sokrasins/name-tag/docs/nametag_back_render_bottom.png

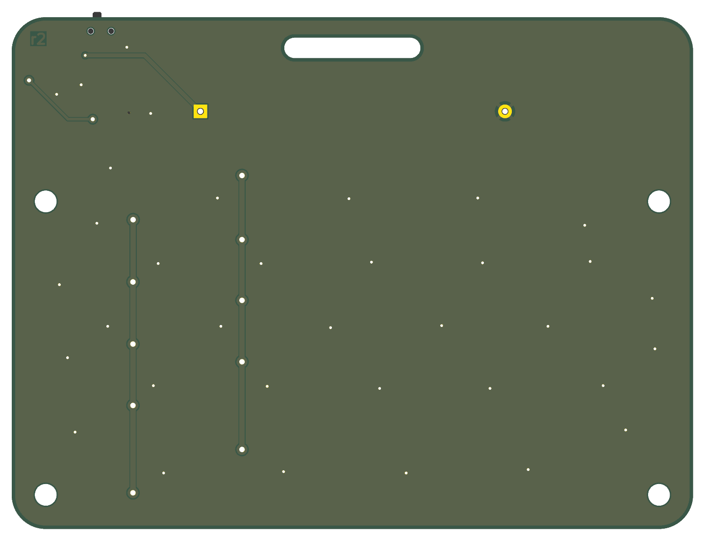
docs/nametag_back_render_bottom.png
