sokrasins/name-tag/docs/nametag_front_render_bottom.png

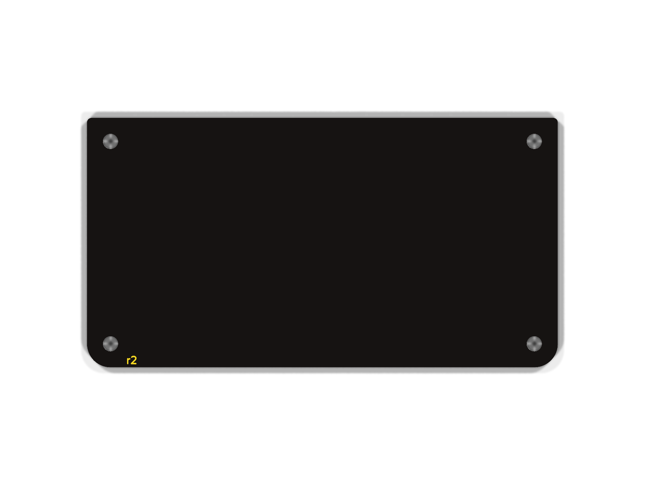
docs/nametag_front_render_bottom.png
