sokrasins/name-tag/bom/bom.csv

 | Sourced | References | Value | Footprint | Quantity | LCSC Part No. | Digikey Part No.
1 | x | C1 | 2.2 uF | C_0805_2012Metric | 1 | C19110
2 | x | C2 | 22 uF | C_0805_2012Metric | 1 | C602037
3 | x | R1, R2, R3, R4, R5, R6, R7, R8, R9, R10, R11, R12, R13, R14, R15, R16, R17, R18, R19, R20, R21, R22, R23, R24, R25, R26, R27 | 1k | R_0805_2012Metric | 27 | C95781
4 | x | L1 | 4.7 uH | L_0805_2012Metric | 1 | C395016
5 | x | D1, D2, D3, D4, D5, D6, D7, D8, D9, D10, D11, D12, D13, D14, D15, D16, D17, D18, D19, D20, D21, D22, D23, D24, D25, D26, D27 | LED | LED_1206_3216Metric | 27 | C3646935
6 | x | U1 | TPS613221ADBV | SOT-23-5 | 1 | C2071121
7 | x | SW2 | SW_SPDT | SW_SPDT_PCM12 | 1 | C221841
8 | x | Q1, Q2, Q3, Q4, Q5, Q6, Q7, Q8, Q9, Q10, Q11, Q12, Q13, Q14, Q15, Q16, Q17, Q18, Q19, Q20, Q21, Q22, Q23, Q24, Q25, Q26, Q27 | BSS138 | SOT-23 | 27 | C2874697
9 | x | BT1 | AAA (1.5V) | BatteryHolder_Keystone_2466_1xAAA | 1 |  | 36-2466-ND
10 | x | RV1 | 10k | Potentiometer_Bourns_TC33X_Vertical | 1 | C719176
11 | x | PCB – Front |  |  | 1
12 | x | PCB – Back |  |  | 1
13 | x | Stencil |  |  | 1
