sokrasins/name-tag/docs/nametag_back_schematic_rev2.pdf

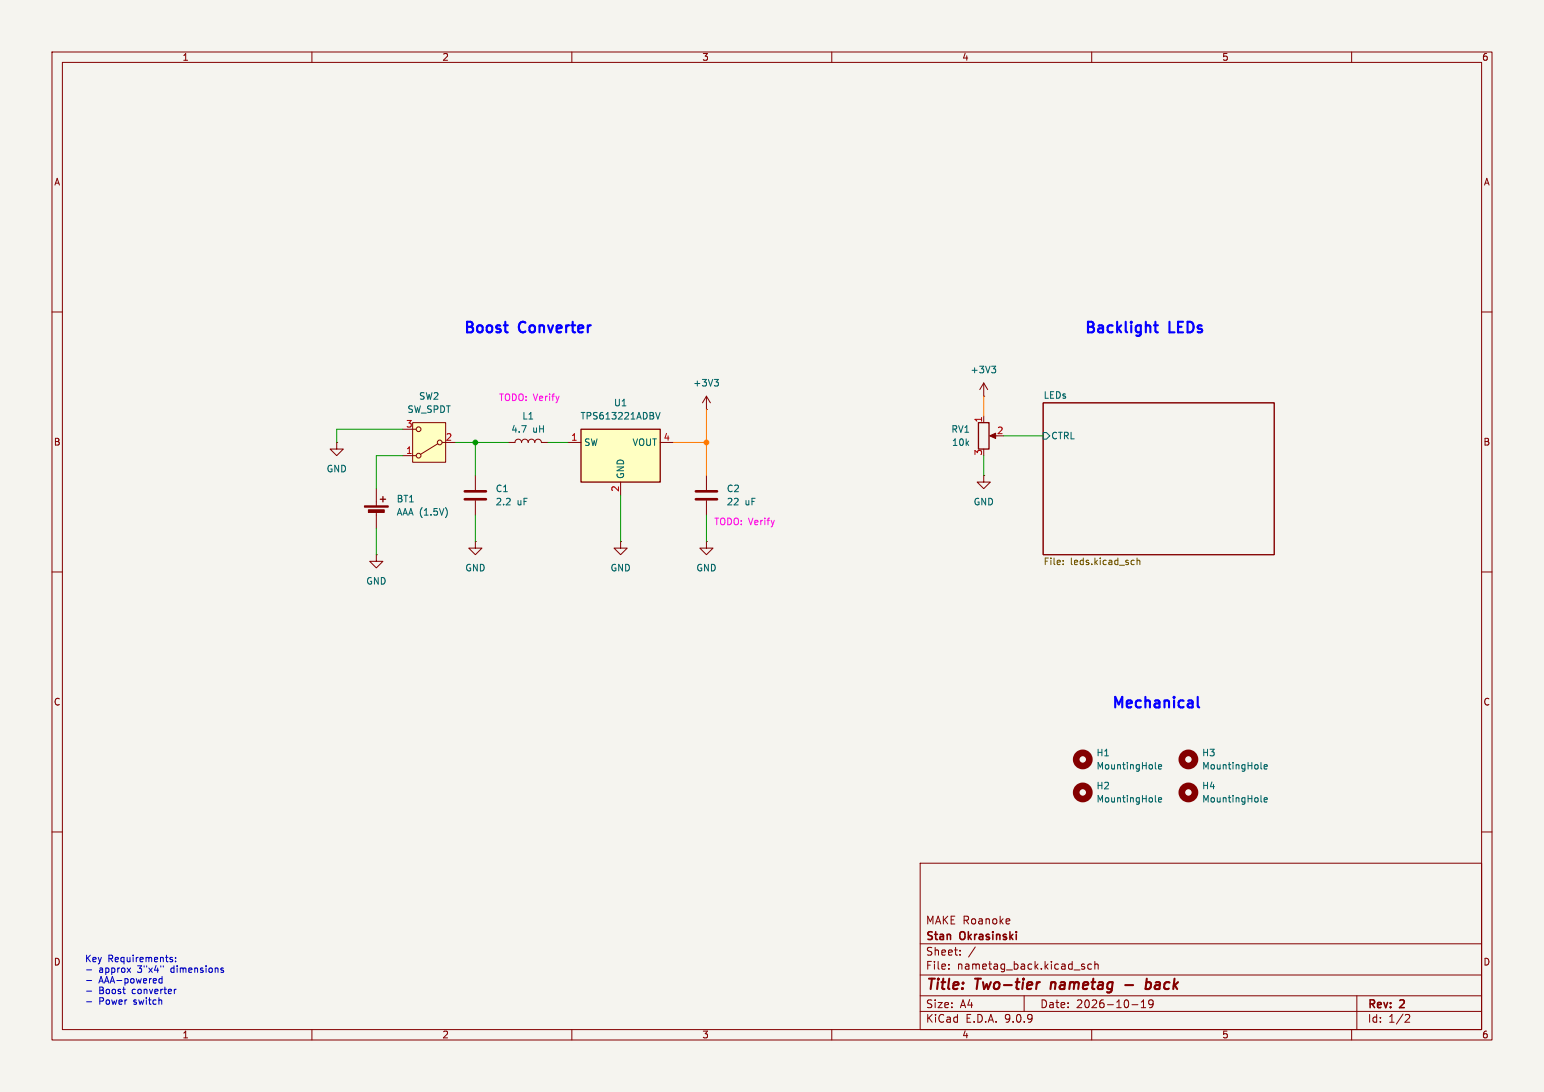
[picture p5: page 1]

H4 MountingHole H3 MountingHole H1 MountingHole H2 MountingHole GND

File: nametag_back.kicad_sch Sheet: / Stan Okrasinski MAKE Roanoke

Key Requirements: - approx 3"x4" dimensions
- AAA-powered
- Boost converter

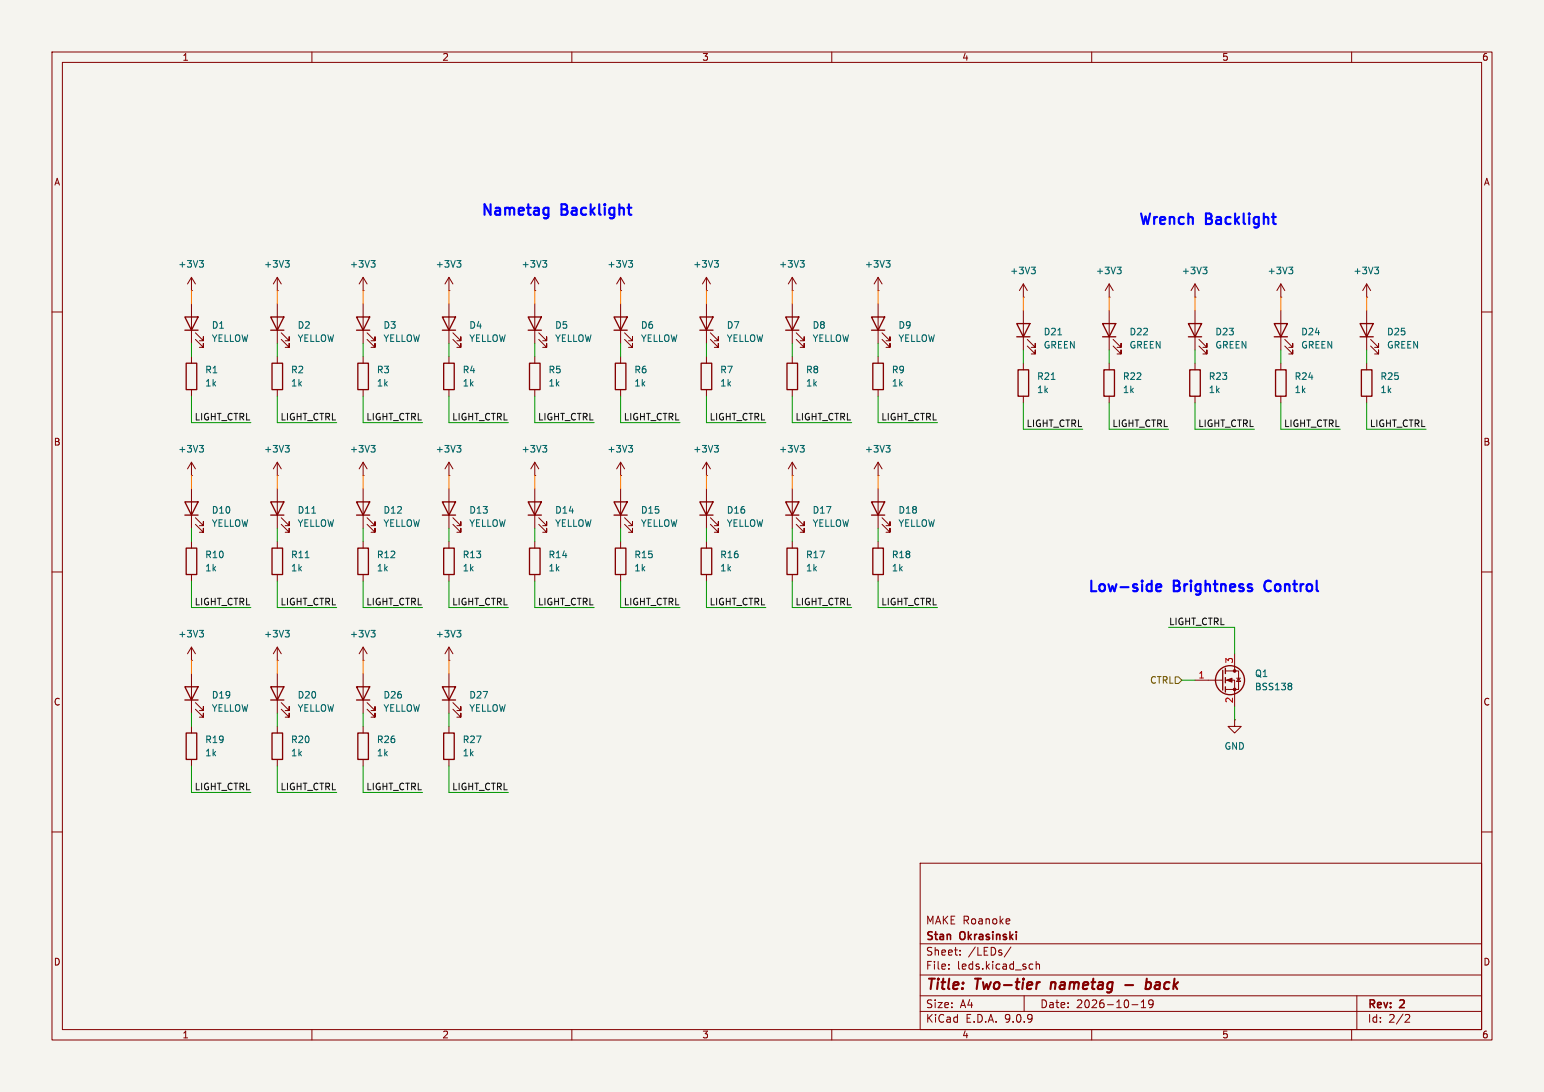
[picture p6: page 2]

File: leds.kicad_sch Sheet: /LEDs/ Stan Okrasinski MAKE Roanoke D14 YELLOW
