sokrasins/name-tag/nametag_back/oven_nametag.kicad_pcb

## KiCad design nametag_back/oven_nametag.kicad_pcb (2026-10-20)

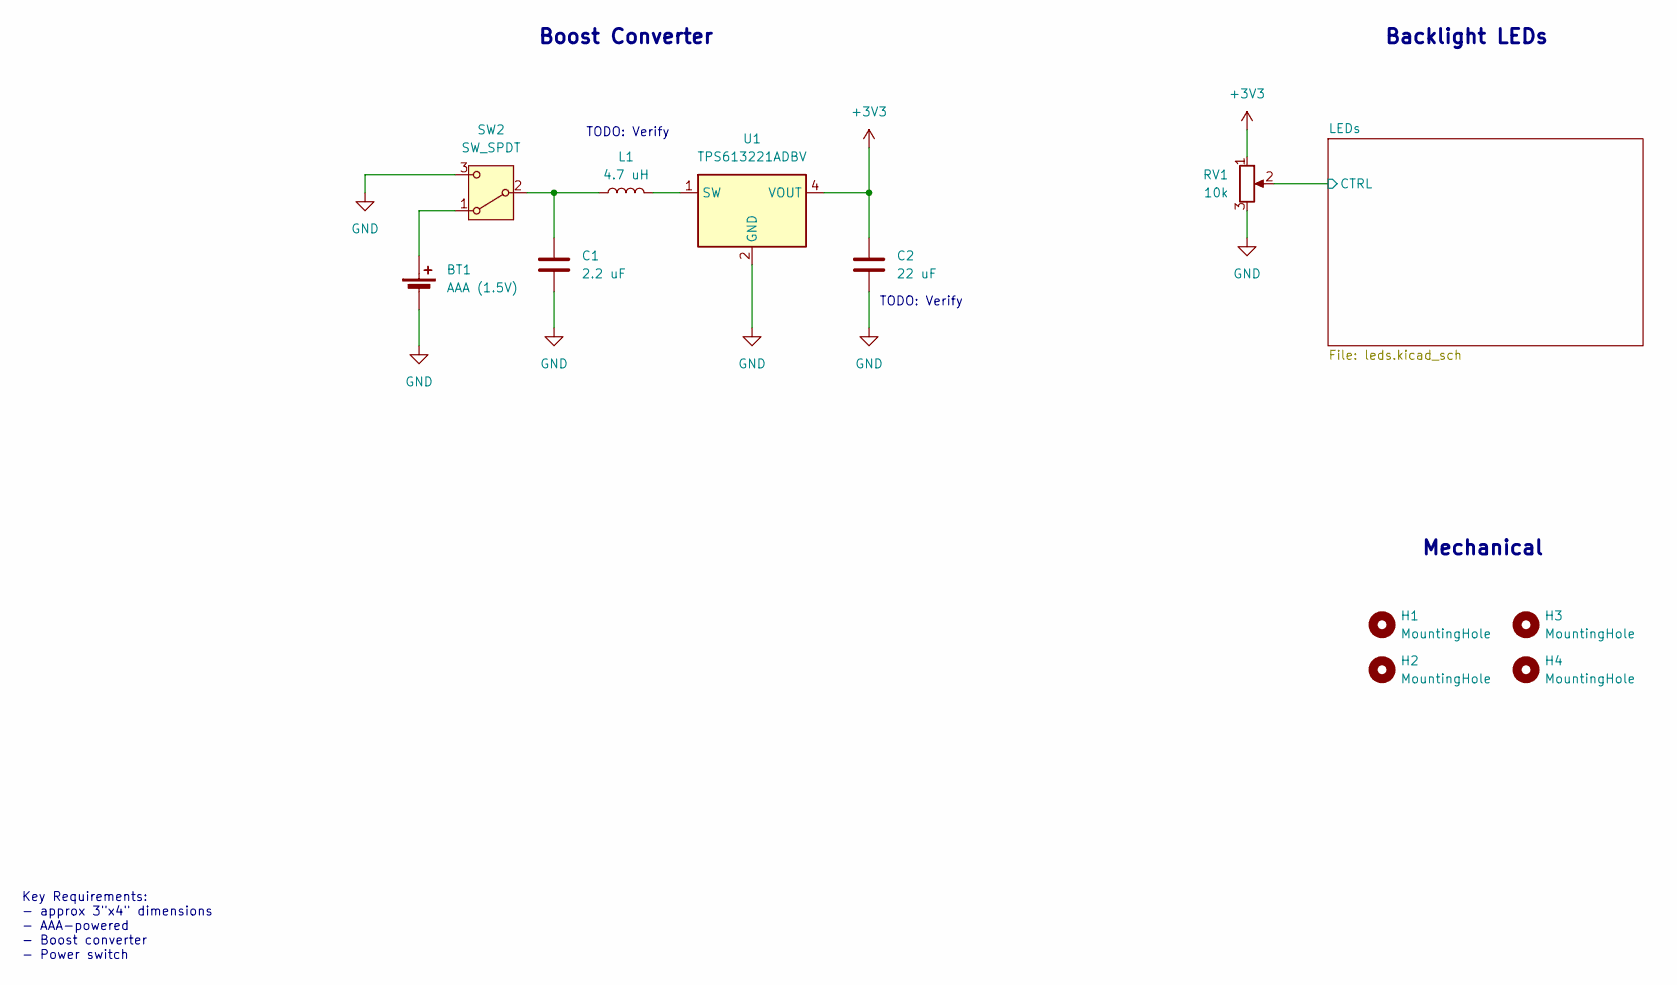
[picture p9: schematic oven_nametag.kicad_sch, Two-tier nametag - back]

Parts:
BT1: AAA (1.5V); BatteryHolder_Keystone_2466_1xAAA
C1: 2.2 uF; C_0805_2012Metric
C2: 22 uF; C_0805_2012Metric
H1, H2, H3, H4: MountingHole; MountingHole_3.2mm_M3
L1: 4.7 uH; L_0805_2012Metric
RV1: 10k; Potentiometer_Bourns_TC33X_Vertical
SW2: SW_SPDT; SW_SPDT_PCM12
U1: TPS613221ADBV; SOT-23-5

Connections:
+3V3: C2.1, RV1.1, U1.4 (VOUT); also elsewhere on the board
/LEDs/CTRL: RV1.2; also elsewhere on the board
GND: BT1.2 (-), C1.2, C2.2, RV1.3, SW2.3 (C), U1.2 (GND); also elsewhere on the board
unnamed: BT1.1 (+), SW2.1 (A)
unnamed: C1.1, L1.1, SW2.2 (B)
unnamed: L1.2, U1.1 (SW)

Notes on the sheet:
Backlight LEDs
TODO: Verify
Boost Converter
Key Requirements: - approx 3"x4" dimensions - AAA-powered - Boost converter - Power switch
Mechanical

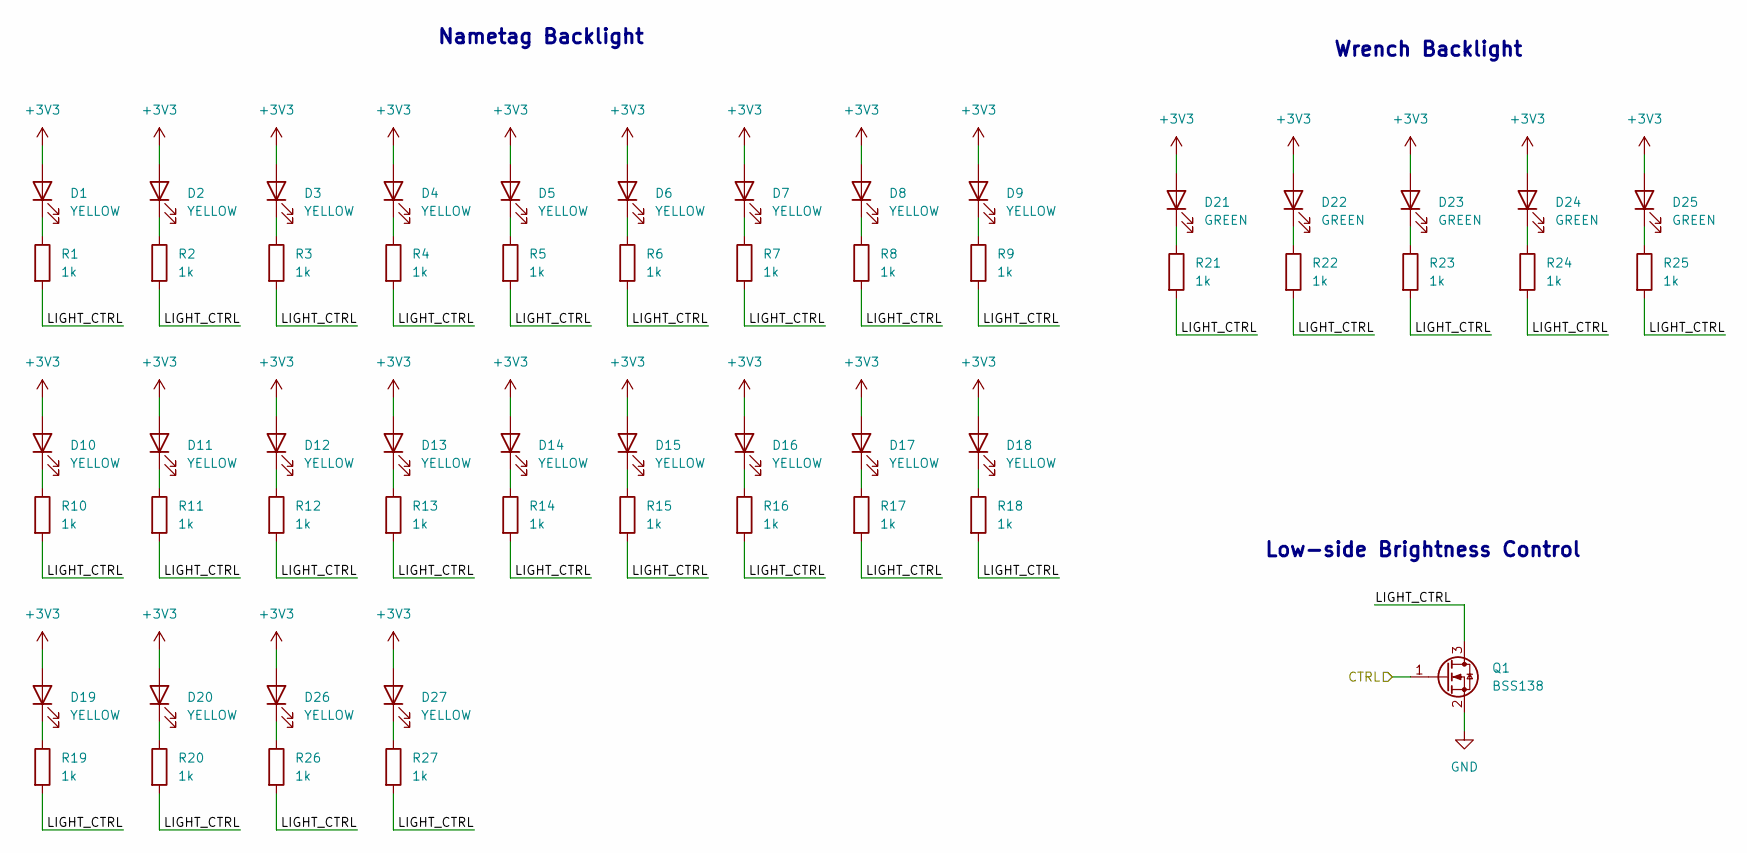
[picture p10: schematic leds.kicad_sch, Two-tier nametag - back]

Parts:
D1, D2, D3, D4, D5, D6, D7, D8, D9, D10, D11, D12, D13, D14, D15, D16, D17, D18, D19, D20, D26, D27: YELLOW; LED_1206_3216Metric
D21, D22, D23, D24, D25: GREEN; LED_1206_3216Metric
Q1: BSS138; SOT-23
R1, R2, R3, R4, R5, R6, R7, R8, R9, R10, R11, R12, R13, R14, R15, R16, R17, R18, R19, R20, R21, R22, R23, R24, R25, R26, R27: 1k; R_0805_2012Metric

Connections:
+3V3: D1.2 (A), D2.2 (A), D3.2 (A), D4.2 (A), D5.2 (A), D6.2 (A), D7.2 (A), D8.2 (A), D9.2 (A), D10.2 (A), D11.2 (A), D12.2 (A), D13.2 (A), D14.2 (A), D15.2 (A), D16.2 (A), D17.2 (A), D18.2 (A), D19.2 (A), D20.2 (A), D21.2 (A), D22.2 (A), D23.2 (A), D24.2 (A), D25.2 (A), D26.2 (A), D27.2 (A); also elsewhere on the board
/LEDs/CTRL: Q1.1 (G); also elsewhere on the board
/LEDs/LIGHT_CTRL: Q1.3 (D), R1.2, R2.2, R3.2, R4.2, R5.2, R6.2, R7.2, R8.2, R9.2, R10.2, R11.2, R12.2, R13.2, R14.2, R15.2, R16.2, R17.2, R18.2, R19.2, R20.2, R21.2, R22.2, R23.2, R24.2, R25.2, R26.2, R27.2
GND: Q1.2 (S); also elsewhere on the board
unnamed: D1.1 (K), R1.1
unnamed: D2.1 (K), R2.1
unnamed: D3.1 (K), R3.1
unnamed: D4.1 (K), R4.1
unnamed: D5.1 (K), R5.1
unnamed: D6.1 (K), R6.1
unnamed: D7.1 (K), R7.1
unnamed: D8.1 (K), R8.1
unnamed: D9.1 (K), R9.1
unnamed: D10.1 (K), R10.1
unnamed: D11.1 (K), R11.1
unnamed: D12.1 (K), R12.1
unnamed: D13.1 (K), R13.1
unnamed: D14.1 (K), R14.1
unnamed: D15.1 (K), R15.1
unnamed: D16.1 (K), R16.1
unnamed: D17.1 (K), R17.1
unnamed: D18.1 (K), R18.1
unnamed: D19.1 (K), R19.1
unnamed: D20.1 (K), R20.1
unnamed: D21.1 (K), R21.1
unnamed: D22.1 (K), R22.1
unnamed: D23.1 (K), R23.1
unnamed: D24.1 (K), R24.1
unnamed: D25.1 (K), R25.1
unnamed: D26.1 (K), R26.1
unnamed: D27.1 (K), R27.1

Notes on the sheet:
Nametag Backlight
Wrench Backlight
Low-side Brightness Control

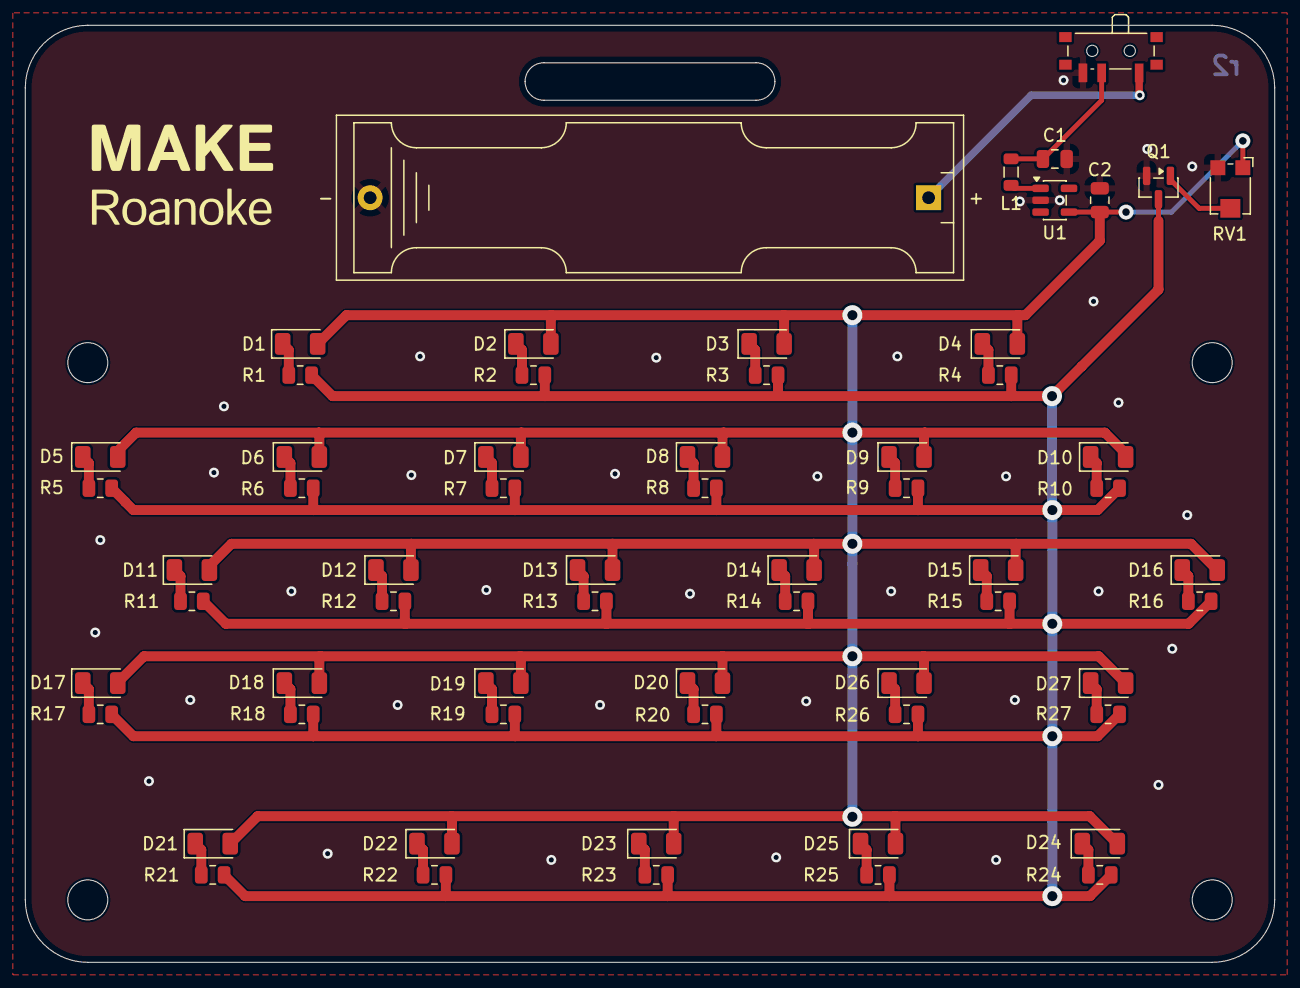
[picture p11: board oven_nametag.kicad_pcb from above]

Board: 2 copper layers, 100.0 x 75.0 mm, 66 parts (0 on the bottom side), 34 nets.
