sokrasins/name-tag/(commit log)

2026-10-15 First ideas on schematic
2026-10-17 Added schematic
2026-10-18 PCB with silk option 1
2026-10-18 Sent to pcbway
2026-10-20 Finish both pcbs for a two-tier PCB
2026-10-20 Remove all but one low-side mosfets
2026-10-20 Add script to regenerate PCB renders with kicad-cli
    Claude-Session: https://claude.ai/code/session_011aeW9thsW1AHj9zWSjvebQ
2026-10-20 Export back board schematic PDF from render script
    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
2026-10-20 Append schematic revision to schematic PDF filename
    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
2026-10-21 Added power analysis output from claude
2026-10-22 Add schematic and pcb links to readme
2026-10-22 rename assembly doc
2026-10-22 Added bom
2026-10-22 Update pcb render links
